rashedulalbab253/three-phase-inverter/(list of files, drawings)

Other design files:
sq.sim1
