rashedulalbab253/three-phase-inverter/Square Wave/backup.ino

//int del = 3333; //60 degre del
//int deadtime = 2; //2us
//#define RH 2
//#define RL 3
//#define YH 4
//#define YL 5
//#define BH 6
//#define BL 7
//void setup() {
//  pinMode (RH, OUTPUT);
//  pinMode (RL, OUTPUT);
//  pinMode (YH, OUTPUT);
//  pinMode (YL, OUTPUT);
//  pinMode (BH, OUTPUT);
//  pinMode (BL, OUTPUT);
//  digitalWrite(RH, LOW);
//  digitalWrite(RL, LOW);
//  digitalWrite(YH, LOW);
//  digitalWrite(YL, LOW);
//  digitalWrite(BH, LOW);
//  digitalWrite(BL, LOW);
//}
//void loop() {
//  //0 to BH0 deg
//  digitalWrite(RH, HIGH); //
//  digitalWrite(BH, HIGH);
//  digitalWrite(YL, HIGH);
//  delayMicroseconds(del);
//  //BH0 to 180 deg
//  //RH,YL remain high
//  digitalWrite(BH, LOW);
//  digitalWrite(BL, HIGH);
//  //180 to RHYH0 deg
//  delayMicroseconds(del);
//  digitalWrite(YL, LOW);
//  digitalWrite(YH, HIGH);
//
//
//  delayMicroseconds(del);
//  digitalWrite(RH, LOW);
//  digitalWrite(RL, HIGH);
//
//
//  delayMicroseconds(del);
//  digitalWrite(BL, LOW);
//  digitalWrite(BH, HIGH);
//
//
//  delayMicroseconds(del);
//  digitalWrite(YH, LOW);
//  digitalWrite(YL, HIGH);
//
//  delayMicroseconds(del);
//  digitalWrite(RL, LOW);
//
//}
