rashedulalbab253/three-phase-inverter/Square Wave/delay.ino

void _delayMicroseconds(unsigned long delayTime) {
    unsigned long  startTime = micros();
    while ((micros() - startTime) < delayTime) {
        // Busy wait until the delay time has elapsed
       //Serial.println(delayTime);
    }
    //delayMicroseconds(delayTime);
   //while(1) Serial.println("666");
}
